MachFour/ambika/controller/hardware_design/pcb/max/Mobo-v09.brd

## EAGLE design controller/hardware_design/pcb/max/Mobo-v09.brd (2020-03-29)

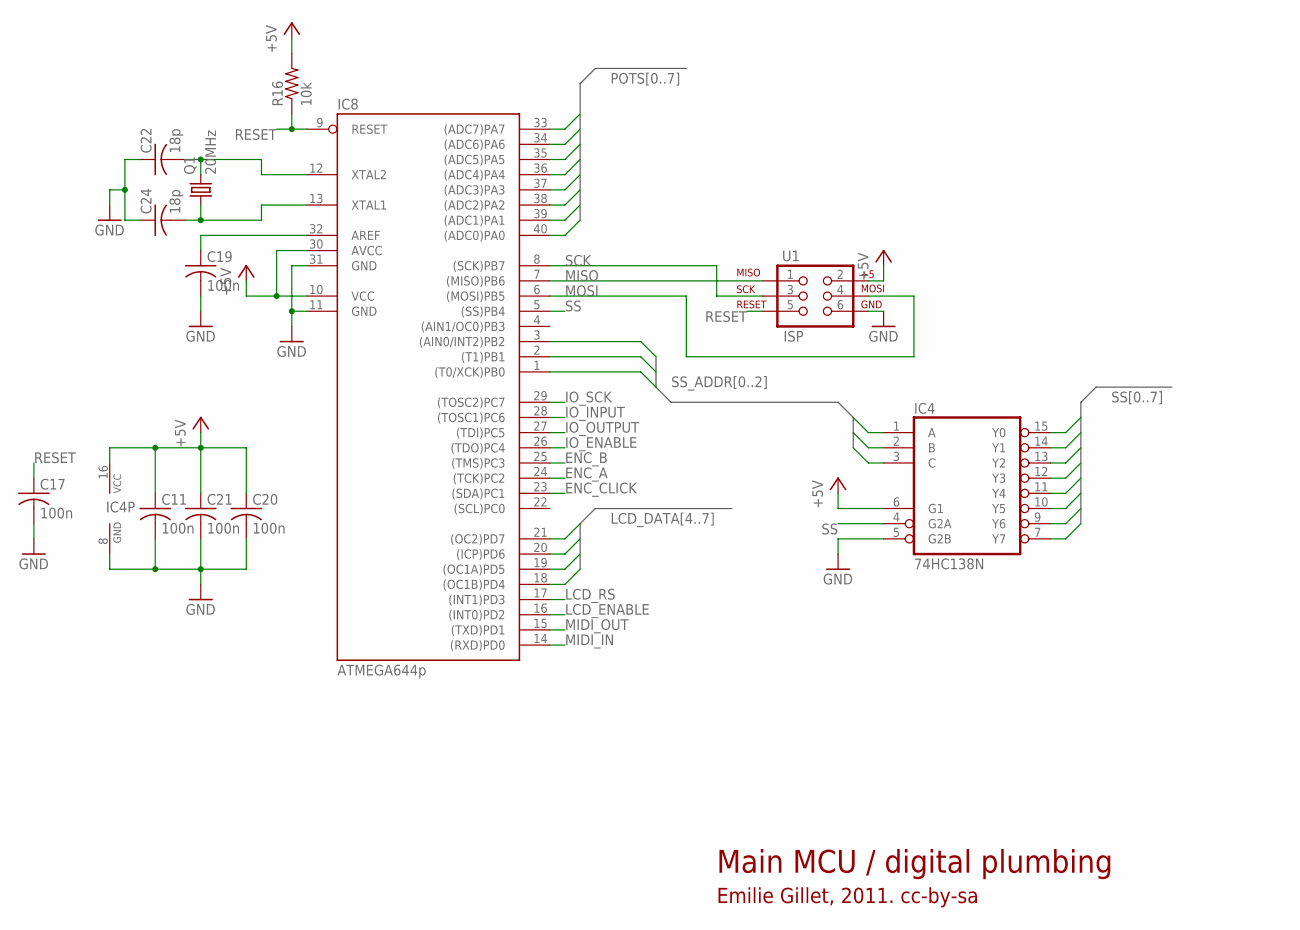
[picture p1: schematic Mobo-v09.sch, sheet 1]

Parts:
C11, C17, C19, C20, C21: 100n; C025-024X044
C22, C24: 18p; C025-024X044
IC4: 74HC138N; DIL16
IC8: ATMEGA644p; DIL40
Q1: 20MHz; HC49U-V
R16: 10k; 0204/7
U1: ISP; 2X3

Connections:
+5V: C11.1, C20.1, C21.1, IC4.6 (G1), IC4.16 (VCC), IC8.10 (VCC), IC8.30 (AVCC), R16.2, U1.2; also elsewhere on the board
ENC_A: IC8.24 ((TCK)PC2); also elsewhere on the board
ENC_B: IC8.25 ((TMS)PC3); also elsewhere on the board
ENC_CLICK: IC8.23 ((SDA)PC1); also elsewhere on the board
GND: C11.2, C17.2, C19.2, C20.2, C21.2, C22.1, C24.1, IC4.5 (G2B), IC4.8 (GND), IC8.11 (GND), IC8.31 (GND), U1.6; also elsewhere on the board
IO_ENABLE: IC8.26 ((TDO)PC4); also elsewhere on the board
IO_INPUT: IC8.28 ((TOSC1)PC6); also elsewhere on the board
IO_OUTPUT: IC8.27 ((TDI)PC5); also elsewhere on the board
IO_SCK: IC8.29 ((TOSC2)PC7); also elsewhere on the board
LCD_DATA4: IC8.18 ((OC1B)PD4); also elsewhere on the board
LCD_DATA5: IC8.19 ((OC1A)PD5); also elsewhere on the board
LCD_DATA6: IC8.20 ((ICP)PD6); also elsewhere on the board
LCD_DATA7: IC8.21 ((OC2)PD7); also elsewhere on the board
LCD_ENABLE: IC8.16 ((INT0)PD2); also elsewhere on the board
LCD_RS: IC8.17 ((INT1)PD3); also elsewhere on the board
MIDI_IN: IC8.14 ((RXD)PD0); also elsewhere on the board
MIDI_OUT: IC8.15 ((TXD)PD1); also elsewhere on the board
MISO: IC8.7 ((MISO)PB6), U1.1; also elsewhere on the board
MOSI: IC8.6 ((MOSI)PB5), U1.4; also elsewhere on the board
unnamed: C19.1, IC8.32 (AREF)
unnamed: C24.2, IC8.13 (XTAL1), Q1.1
unnamed: C22.2, IC8.12 (XTAL2), Q1.2
POTS0: IC8.40 ((ADC0)PA0); also elsewhere on the board
POTS1: IC8.39 ((ADC1)PA1); also elsewhere on the board
POTS2: IC8.38 ((ADC2)PA2); also elsewhere on the board
POTS3: IC8.37 ((ADC3)PA3); also elsewhere on the board
POTS4: IC8.36 ((ADC4)PA4); also elsewhere on the board
POTS5: IC8.35 ((ADC5)PA5); also elsewhere on the board
POTS6: IC8.34 ((ADC6)PA6); also elsewhere on the board
POTS7: IC8.33 ((ADC7)PA7); also elsewhere on the board
RESET: C17.1, IC8.9 (RESET), R16.1, U1.5
SCK: IC8.8 ((SCK)PB7), U1.3; also elsewhere on the board
SS: IC4.4 (G2A), IC8.5 ((SS)PB4)
SS0: IC4.15 (Y0); also elsewhere on the board
SS1: IC4.14 (Y1); also elsewhere on the board
SS2: IC4.13 (Y2); also elsewhere on the board
SS3: IC4.12 (Y3); also elsewhere on the board
SS4: IC4.11 (Y4); also elsewhere on the board
SS5: IC4.10 (Y5); also elsewhere on the board
SS6: IC4.9 (Y6); also elsewhere on the board
SS7: IC4.7 (Y7); also elsewhere on the board
SS_ADDR0: IC4.1 (A), IC8.1 ((T0/XCK)PB0)
SS_ADDR1: IC4.2 (B), IC8.2 ((T1)PB1)
SS_ADDR2: IC4.3 (C), IC8.3 ((AIN0/INT2)PB2)

Notes on the sheet:
Main MCU / digital plumbing
Emilie Gillet, 2011. cc-by-sa

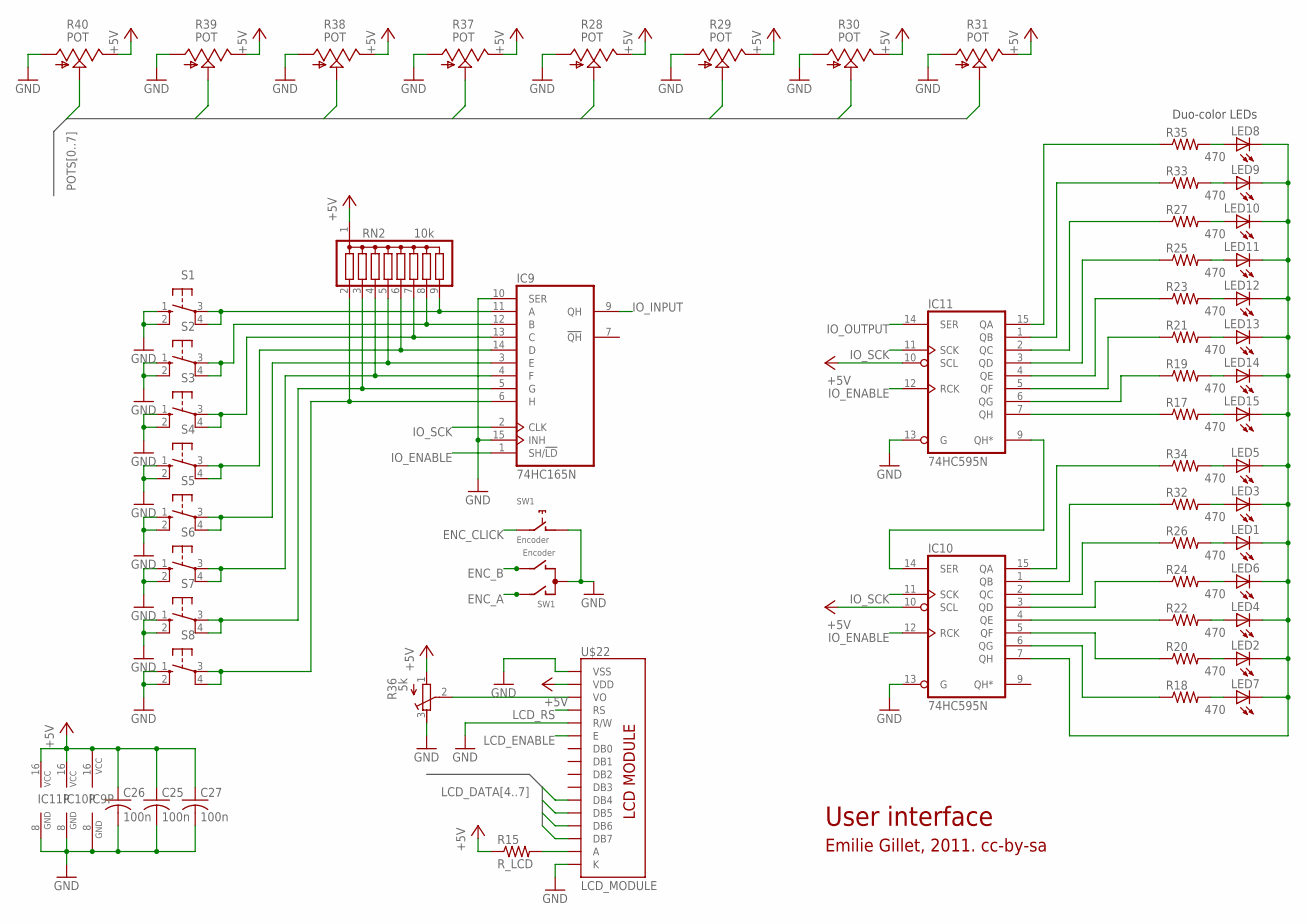
[picture p2: schematic Mobo-v09.sch, sheet 2]

Parts:
C25, C26, C27: 100n; C025-024X044
IC9: 74HC165N; DIL16
IC10, IC11: 74HC595N; DIL16
LED1, LED2, LED3, LED4, LED5, LED6, LED7, LED8, LED9, LED10, LED11, LED12, LED13, LED14, LED15: LED3MM
R15: R_LCD; 0204/7
R17, R18, R19, R20, R21, R22, R23, R24, R25, R26, R27, R32, R33, R34, R35: 470; 0204/7
R28, R29, R30, R31, R37, R38, R39, R40: POT; ALPS_POT_VERTICAL
R36: 5k; RTRIM3339P
RN2: 10k; SIL9
S1, S2, S3, S4, S5, S6, S7, S8: 40-XX; B3F-40XX
SW1: Encoder; ALPS_EC12E_SW
U$22: LCD_MODULE; LCD_MODULE_2X40

Connections:
+5V: C25.1, C26.1, C27.1, IC9.16 (VCC), IC10.10 (SCL), IC10.16 (VCC), IC11.10 (SCL), IC11.16 (VCC), R15.1, R28.P$1 (E), R29.P$1 (E), R30.P$1 (E), R31.P$1 (E), R36.1 (E), R37.P$1 (E), R38.P$1 (E), R39.P$1 (E), R40.P$1 (E), RN2.1, U$22.2 (VDD); also elsewhere on the board
ENC_A: SW1.A; also elsewhere on the board
ENC_B: SW1.B; also elsewhere on the board
ENC_CLICK: SW1.E (2); also elsewhere on the board
GND: C25.2, C26.2, C27.2, IC9.8 (GND), IC9.10 (SER), IC9.15 (INH), IC10.8 (GND), IC10.13 (G), IC11.8 (GND), IC11.13 (G), R28.P$3 (A), R29.P$3 (A), R30.P$3 (A), R31.P$3 (A), R36.3 (A), R37.P$3 (A), R38.P$3 (A), R39.P$3 (A), R40.P$3 (A), S1.1 (S), S1.2 (S1), S2.1 (S), S2.2 (S1), S3.1 (S), S3.2 (S1), S4.1 (S), S4.2 (S1), S5.1 (S), S5.2 (S1), S6.1 (S), S6.2 (S1), S7.1 (S), S7.2 (S1), S8.1 (S), S8.2 (S1), SW1.C, SW1.D (1), U$22.1 (VSS), U$22.5 (R/W), U$22.16 (K); also elsewhere on the board
IO_ENABLE: IC9.1 (SH/!LD), IC10.12 (RCK), IC11.12 (RCK); also elsewhere on the board
IO_INPUT: IC9.9 (QH); also elsewhere on the board
IO_OUTPUT: IC11.14 (SER); also elsewhere on the board
IO_SCK: IC9.2 (CLK), IC10.11 (SCK), IC11.11 (SCK); also elsewhere on the board
LCD_DATA4: U$22.11 (DB4); also elsewhere on the board
LCD_DATA5: U$22.12 (DB5); also elsewhere on the board
LCD_DATA6: U$22.13 (DB6); also elsewhere on the board
LCD_DATA7: U$22.14 (DB7); also elsewhere on the board
LCD_ENABLE: U$22.6 (E); also elsewhere on the board
LCD_RS: U$22.4 (RS); also elsewhere on the board
unnamed: IC11.2 (QC), R27.1
unnamed: IC9.3 (E), RN2.5, S5.3, S5.4 (P1)
unnamed: IC9.5 (G), RN2.3, S7.3, S7.4 (P1)
unnamed: IC9.4 (F), RN2.4, S6.3, S6.4 (P1)
unnamed: IC9.14 (D), RN2.6, S4.3, S4.4 (P1)
unnamed: R36.2 (S), U$22.3 (VO)
unnamed: IC9.11 (A), RN2.9, S1.3, S1.4 (P1)
unnamed: IC11.15 (QA), R35.1
unnamed: IC11.1 (QB), R33.1
unnamed: IC11.3 (QD), R25.1
unnamed: IC11.4 (QE), R23.1
unnamed: IC11.5 (QF), R21.1
unnamed: IC11.7 (QH), R17.1
unnamed: IC11.6 (QG), R19.1
unnamed: LED8.A, R35.2
unnamed: LED9.A, R33.2
unnamed: LED10.A, R27.2
unnamed: LED11.A, R25.2
unnamed: LED12.A, R23.2
unnamed: LED13.A, R21.2
unnamed: LED14.A, R19.2
unnamed: LED15.A, R17.2
unnamed: IC10.7 (QH), LED1.K (C), LED2.K (C), LED3.K (C), LED4.K (C), LED5.K (C), LED6.K (C), LED7.K (C), LED8.K (C), LED9.K (C), LED10.K (C), LED11.K (C), LED12.K (C), LED13.K (C), LED14.K (C), LED15.K (C)
unnamed: IC10.15 (QA), R34.1
unnamed: IC10.1 (QB), R32.1
unnamed: IC10.3 (QD), R24.1
unnamed: IC10.4 (QE), R22.1
unnamed: IC10.5 (QF), R20.1
unnamed: LED5.A, R34.2
unnamed: LED3.A, R32.2
unnamed: R15.2, U$22.15 (A)
unnamed: LED1.A, R26.2
unnamed: LED6.A, R24.2
unnamed: LED4.A, R22.2
unnamed: LED2.A, R20.2
unnamed: IC10.14 (SER), IC11.9 (QH*)
unnamed: IC9.12 (B), RN2.8, S2.3, S2.4 (P1)
unnamed: IC10.2 (QC), R26.1
unnamed: IC9.13 (C), RN2.7, S3.3, S3.4 (P1)
unnamed: IC9.6 (H), RN2.2, S8.3, S8.4 (P1)
unnamed: LED7.A, R18.2
unnamed: IC10.6 (QG), R18.1
POTS0: R40.P$2 (S); also elsewhere on the board
POTS1: R39.P$2 (S); also elsewhere on the board
POTS2: R38.P$2 (S); also elsewhere on the board
POTS3: R37.P$2 (S); also elsewhere on the board
POTS4: R28.P$2 (S); also elsewhere on the board
POTS5: R29.P$2 (S); also elsewhere on the board
POTS6: R30.P$2 (S); also elsewhere on the board
POTS7: R31.P$2 (S); also elsewhere on the board

Notes on the sheet:
User interface
Duo-color LEDs
Emilie Gillet, 2011. cc-by-sa

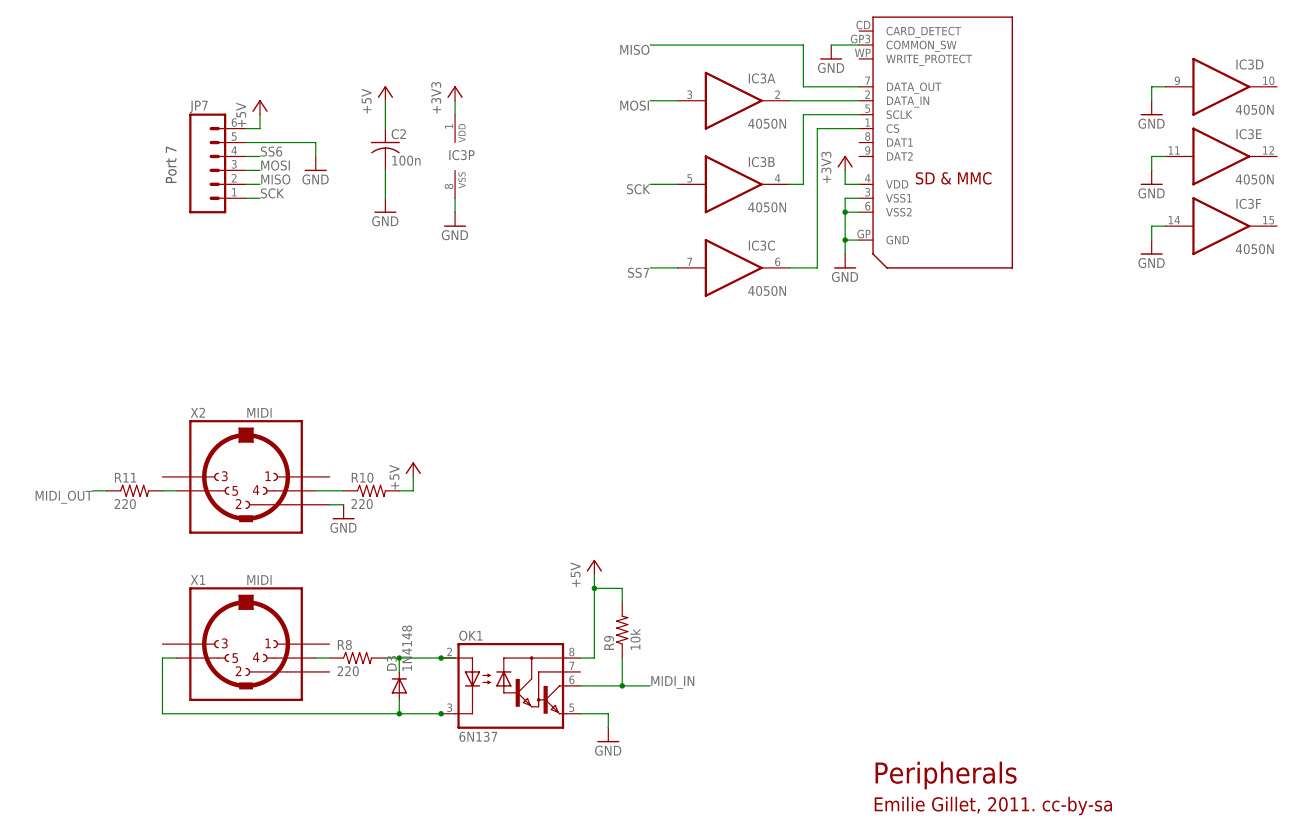
[picture p3: schematic Mobo-v09.sch, sheet 3]

Parts:
C2: 100n; C025-024X044
D3: 1N4148; D-5
IC3: 4050N; DIL16
JP7: M06SIP; 1X06
OK1: 6N137; DIL08
R8, R10, R11: 220; 0204/7
R9: 10k; 0204/7
U$26: SDMMC06132; 06132
X1, X2: MIDI; MAB5SH

Connections:
+3V3: IC3.1 (VDD), U$26.4 (VDD); also elsewhere on the board
+5V: C2.1, JP7.6, OK1.8 (VCC), R9.2, R10.2; also elsewhere on the board
GND: C2.2, IC3.8 (VSS), IC3.9 (I), IC3.11 (I), IC3.14 (I), JP7.5, OK1.5 (GND), U$26.3 (VSS1), U$26.6 (VSS2), U$26.GP (GND), U$26.GP3 (COMMON_SW), X2.2; also elsewhere on the board
MIDI_IN: OK1.6 (VO), R9.1; also elsewhere on the board
MIDI_OUT: R11.1; also elsewhere on the board
MISO: JP7.2, U$26.7 (DATA_OUT); also elsewhere on the board
MOSI: IC3.3 (I), JP7.3; also elsewhere on the board
MOSI_3V3: IC3.2 (O), U$26.2 (DATA_IN)
unnamed: R11.2, X2.5
unnamed: D3.C, OK1.2 (A), R8.2
unnamed: R10.1, X2.4
unnamed: R8.1, X1.4
unnamed: D3.A, OK1.3 (C), X1.5
SCK: IC3.5 (I), JP7.1; also elsewhere on the board
SCK_3V3: IC3.4 (O), U$26.5 (SCLK)
SS6: JP7.4; also elsewhere on the board
SS7: IC3.7 (I); also elsewhere on the board
SS7_3V3: IC3.6 (O), U$26.1 (CS)

Notes on the sheet:
Peripherals
Emilie Gillet, 2011. cc-by-sa
Port 7

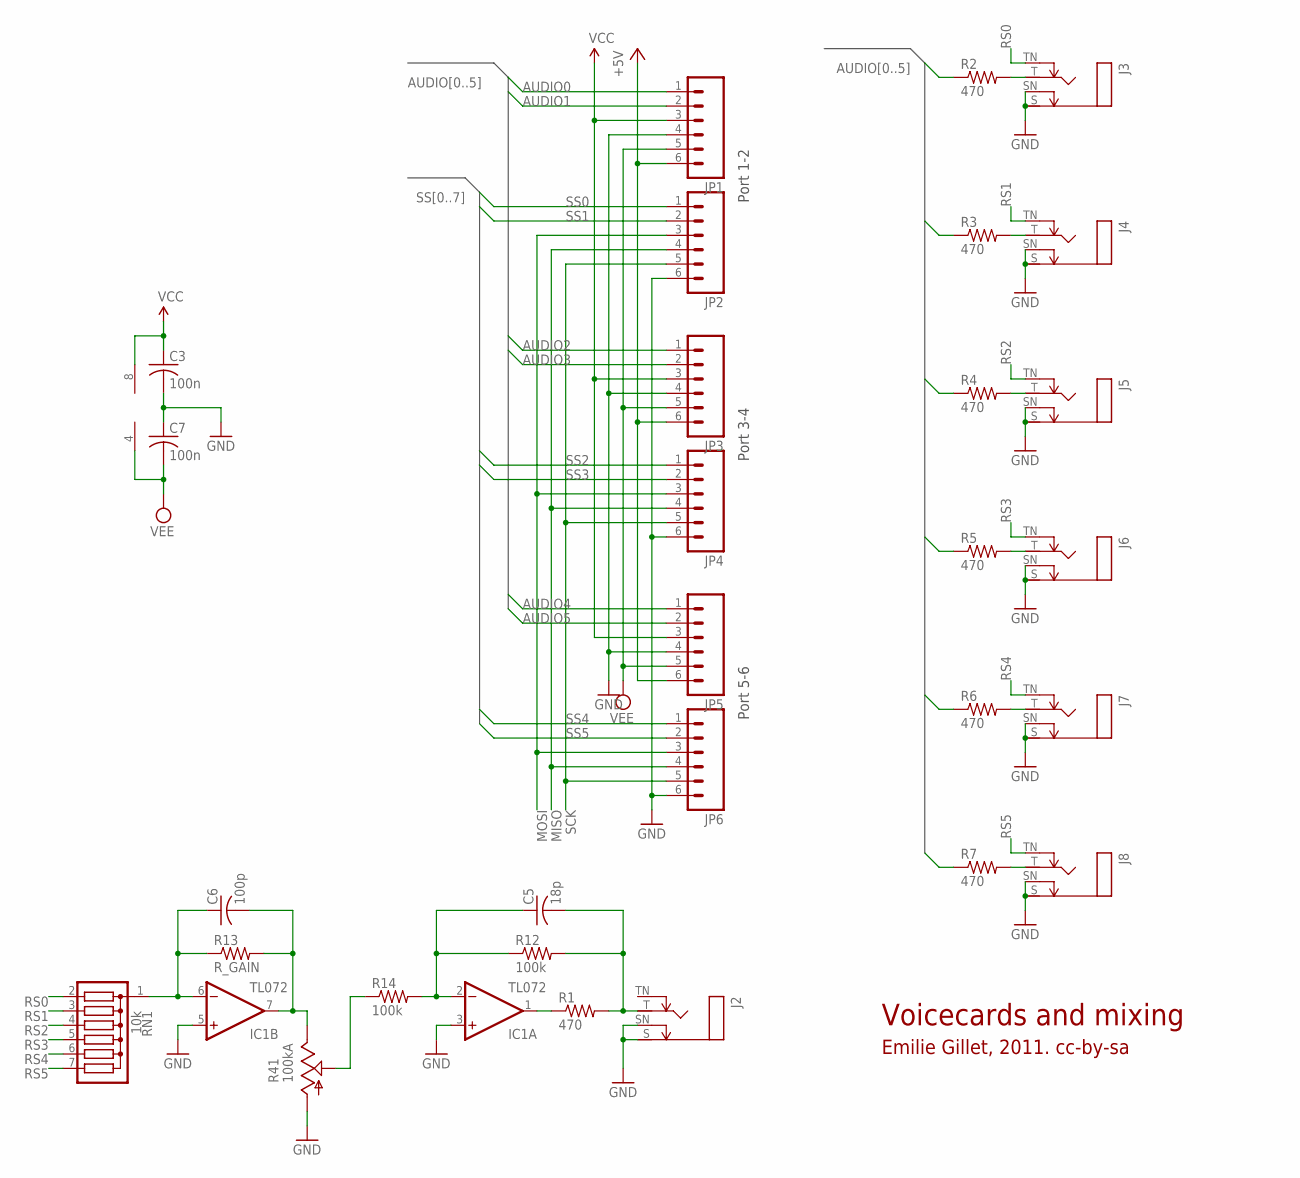
[picture p4: schematic Mobo-v09.sch, sheet 4]

Parts:
C3, C7: 100n; C025-024X044
C5: 18p; C025-024X044
C6: 100p; C025-024X044
IC1: TL072; DIL08
J2, J3, J4, J5, J6, J7, J8: MONOSWSLIM; NRJ4HF
JP1, JP2, JP3, JP4, JP5, JP6: M06SIP; 1X06
R1, R2, R3, R4, R5, R6, R7: 470; 0204/7
R12, R14: 100k; 0204/7
R13: R_GAIN; 0204/7
R41: 100kA; ALPS_POT_VERTICAL
RN1: 10k; SIL7

Connections:
+5V: JP1.6, JP3.6, JP5.6; also elsewhere on the board
AUDIO0: JP1.1, R2.1
AUDIO1: JP1.2, R3.1
AUDIO2: JP3.1, R4.1
AUDIO3: JP3.2, R5.1
AUDIO4: JP5.1, R6.1
AUDIO5: JP5.2, R7.1
GND: C3.2, C7.1, IC1.3 (+IN), IC1.5 (+IN), J2.S, J2.SN, J3.S, J3.SN, J4.S, J4.SN, J5.S, J5.SN, J6.S, J6.SN, J7.S, J7.SN, J8.S, J8.SN, JP1.4, JP2.6, JP3.4, JP4.6, JP5.4, JP6.6, R41.P$3 (A); also elsewhere on the board
MISO: JP2.4, JP4.4, JP6.4; also elsewhere on the board
MOSI: JP2.3, JP4.3, JP6.3; also elsewhere on the board
unnamed: C6.2, IC1.7 (OUT), R13.2, R41.P$1 (E)
unnamed: C6.1, IC1.6 (-IN), R13.1, RN1.1
unnamed: R14.1, R41.P$2 (S)
unnamed: C5.1, IC1.2 (-IN), R12.1, R14.2
unnamed: C5.2, J2.T, R1.2, R12.2
unnamed: J3.T, R2.2
unnamed: J4.T, R3.2
unnamed: J5.T, R4.2
unnamed: J6.T, R5.2
unnamed: J7.T, R6.2
unnamed: J8.T, R7.2
unnamed: IC1.1 (OUT), R1.1
RS0: J3.TN, RN1.2
RS1: J4.TN, RN1.3
RS2: J5.TN, RN1.4
RS3: J6.TN, RN1.5
RS4: J7.TN, RN1.6
RS5: J8.TN, RN1.7
SCK: JP2.5, JP4.5, JP6.5; also elsewhere on the board
SS0: JP2.1; also elsewhere on the board
SS1: JP2.2; also elsewhere on the board
SS2: JP4.1; also elsewhere on the board
SS3: JP4.2; also elsewhere on the board
SS4: JP6.1; also elsewhere on the board
SS5: JP6.2; also elsewhere on the board
VCC: C3.1, IC1.8 (V+), JP1.3, JP3.3, JP5.3; also elsewhere on the board
VEE: C7.2, IC1.4 (V-), JP1.5, JP3.5, JP5.5; also elsewhere on the board

Notes on the sheet:
Voicecards and mixing
Emilie Gillet, 2011. cc-by-sa
Port 1-2
Port 3-4
Port 5-6

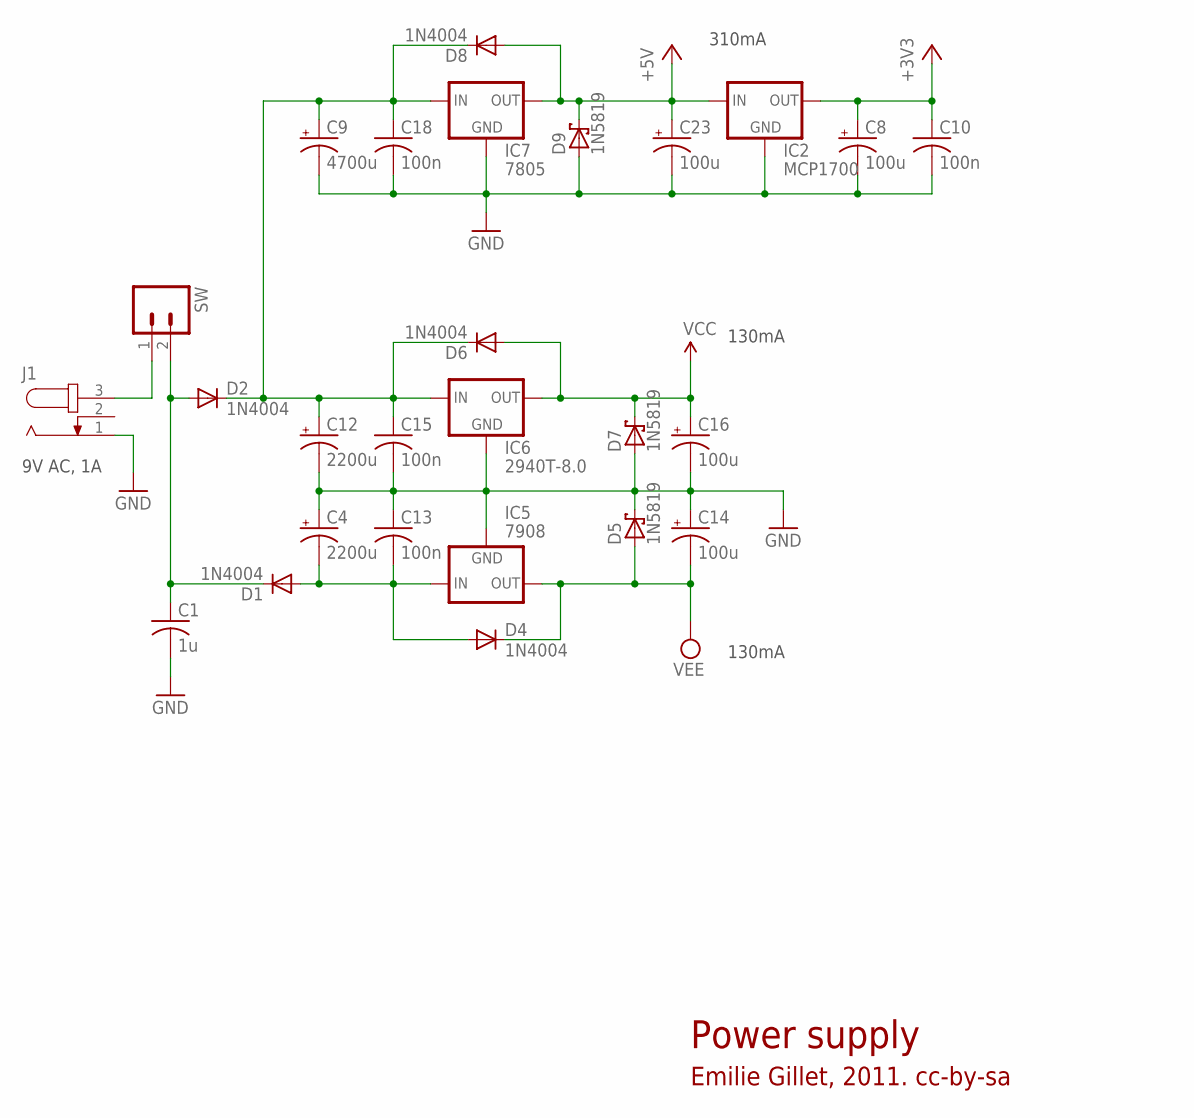
[picture p5: schematic Mobo-v09.sch, sheet 5]

Parts:
C1: 1u; C075-052X106
C4, C12: 2200u; E5-13
C8, C14, C16, C23: 100u; E2,5-7
C9: 4700u; E7,5-16
C10: 100n; C025-024X044
C13, C15, C18: 100n; C025-025X050
D1, D2, D4, D6, D8: 1N4004; DO41-10
D5, D7, D9: 1N5819; DO41-7.6
IC2: MCP1700; TO92-INLINE
IC5: 7908; 79XXL
IC6: 2940T-8.0; 78XXL
IC7: 7805; 78XXL
J1: JACK-PLUG2; SPC4078_BIG_HOLES
SW: M02PTH; 1X02

Connections:
+3V3: C8.+, C10.1, IC2.3 (OUT); also elsewhere on the board
+5V: C23.+, D8.A, D9.C, IC2.2 (IN), IC7.OUT; also elsewhere on the board
GND: C1.2, C4.+, C8.-, C9.-, C10.2, C12.-, C13.1, C14.+, C15.2, C16.-, C18.2, C23.-, D5.C, D7.A, D9.A, IC2.1 (GND), IC5.GND, IC6.GND, IC7.GND, J1.1; also elsewhere on the board
unnamed: J1.3, SW.1
unnamed: C4.-, C13.2, D1.A, D4.A, IC5.IN
unnamed: C9.+, C12.+, C15.1, C18.1, D2.C, D6.C, D8.C, IC6.IN, IC7.IN
unnamed: C1.1, D1.C, D2.A, SW.2
VCC: C16.+, D6.A, D7.C, IC6.OUT; also elsewhere on the board
VEE: C14.-, D4.C, D5.A, IC5.OUT; also elsewhere on the board

Notes on the sheet:
9V AC, 1A
Power supply
Emilie Gillet, 2011. cc-by-sa
130mA
310mA

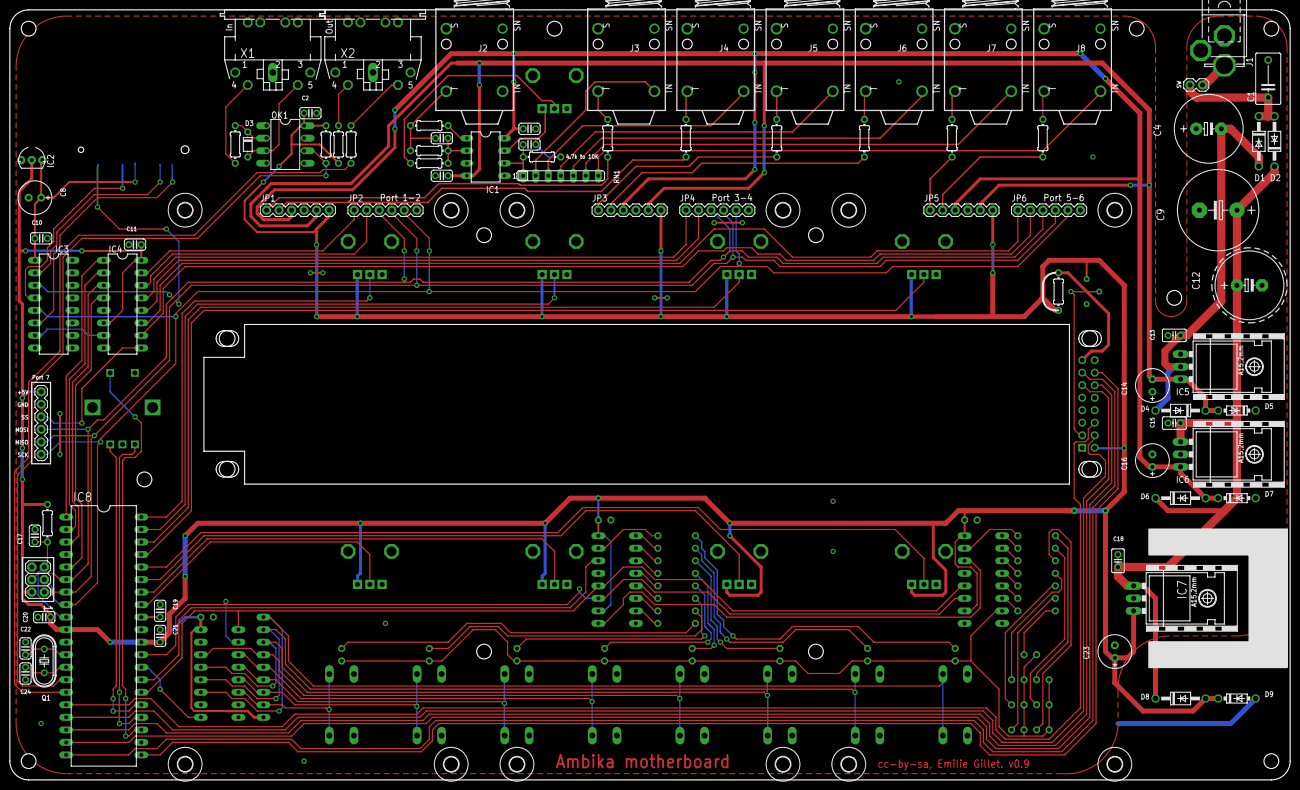
[picture p6: board Mobo-v09.brd from above]

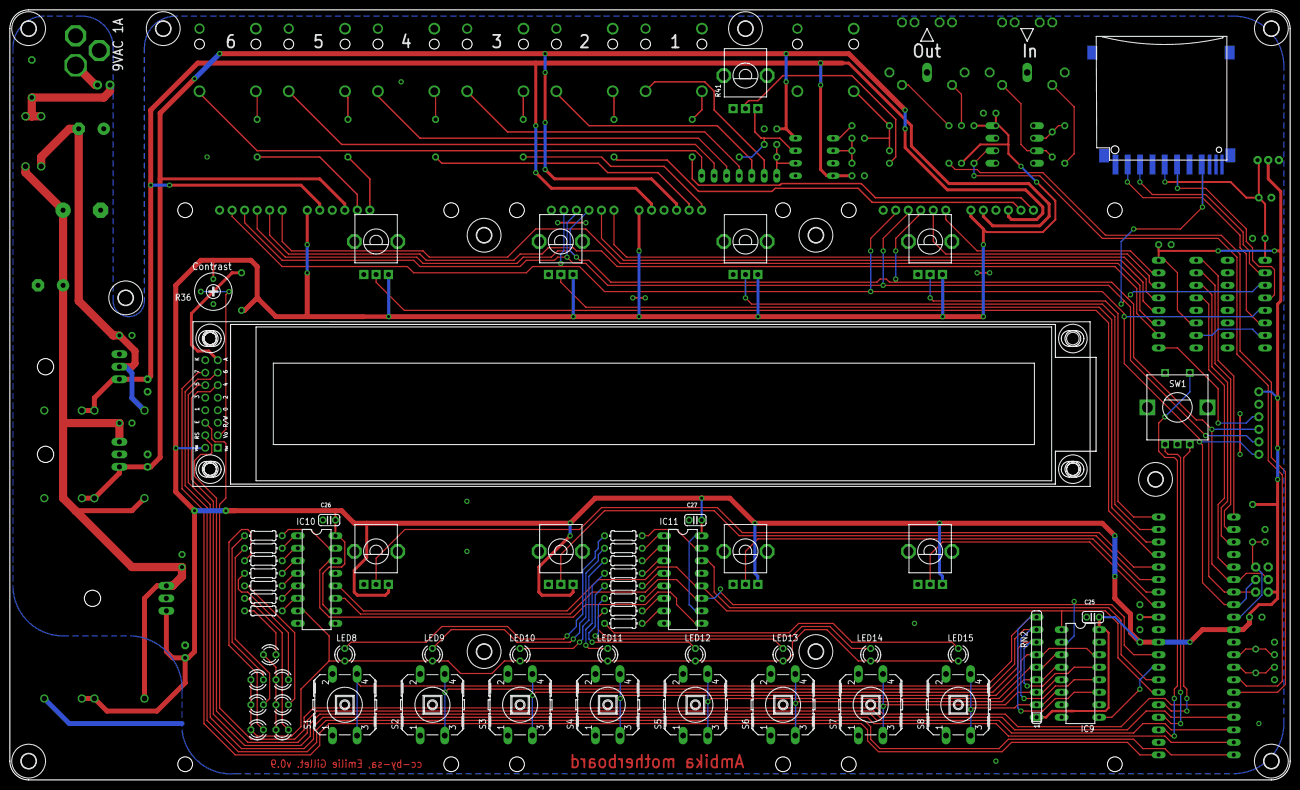
[picture p7: board Mobo-v09.brd from below]

Board: 2 copper layers, 259.7 x 156.2 mm, 165 parts (70 on the bottom side), 125 nets.

Other parts of the board:
U$1: V2_LOGO
U$2, U$3, U$4, U$5, U$6, U$7, U$11, U$12, U$13, U$14, U$15, U$16, U$17, U$18, U$19, U$20, U$21, U$23, U$24, U$25, U$27, U$28, U$29, U$30: 3,0
U$8, U$9, U$10: D02A-L
