MachFour/ambika/controller/resources-bak/resources.h

// Copyright 2009 Emilie Gillet.
//
// Author: Emilie Gillet (emilie.o.gillet@gmail.com)
//
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
// -----------------------------------------------------------------------------
//
// Resources definitions.
//
// Automatically generated with:
// make resources


#ifndef CONTROLLER_RESOURCES_H_
#define CONTROLLER_RESOURCES_H_


#include "avrlib/base.h"

#include <avr/pgmspace.h>


#include "avrlib/resources_manager.h"

namespace ambika {

typedef uint16_t ResourceId;

extern const char* const string_table[];

extern const uint16_t* const lookup_table_table[];

extern const uint8_t* const character_table[];

extern const uint8_t* const waveform_table[];

extern const uint16_t lut_res_lfo_increments[] PROGMEM;
extern const uint16_t lut_res_scale_just[] PROGMEM;
extern const uint16_t lut_res_scale_pythagorean[] PROGMEM;
extern const uint16_t lut_res_scale_1_4_eb[] PROGMEM;
extern const uint16_t lut_res_scale_1_4_e[] PROGMEM;
extern const uint16_t lut_res_scale_1_4_ea[] PROGMEM;
extern const uint16_t lut_res_scale_bhairav[] PROGMEM;
extern const uint16_t lut_res_scale_gunakri[] PROGMEM;
extern const uint16_t lut_res_scale_marwa[] PROGMEM;
extern const uint16_t lut_res_scale_shree[] PROGMEM;
extern const uint16_t lut_res_scale_purvi[] PROGMEM;
extern const uint16_t lut_res_scale_bilawal[] PROGMEM;
extern const uint16_t lut_res_scale_yaman[] PROGMEM;
extern const uint16_t lut_res_scale_kafi[] PROGMEM;
extern const uint16_t lut_res_scale_bhimpalasree[] PROGMEM;
extern const uint16_t lut_res_scale_darbari[] PROGMEM;
extern const uint16_t lut_res_scale_rageshree[] PROGMEM;
extern const uint16_t lut_res_scale_khamaj[] PROGMEM;
extern const uint16_t lut_res_scale_mimal[] PROGMEM;
extern const uint16_t lut_res_scale_parameshwari[] PROGMEM;
extern const uint16_t lut_res_scale_rangeshwari[] PROGMEM;
extern const uint16_t lut_res_scale_gangeshwari[] PROGMEM;
extern const uint16_t lut_res_scale_kameshwari[] PROGMEM;
extern const uint16_t lut_res_scale_pa__kafi[] PROGMEM;
extern const uint16_t lut_res_scale_natbhairav[] PROGMEM;
extern const uint16_t lut_res_scale_m_kauns[] PROGMEM;
extern const uint16_t lut_res_scale_bairagi[] PROGMEM;
extern const uint16_t lut_res_scale_b_todi[] PROGMEM;
extern const uint16_t lut_res_scale_chandradeep[] PROGMEM;
extern const uint16_t lut_res_scale_kaushik_todi[] PROGMEM;
extern const uint16_t lut_res_scale_jogeshwari[] PROGMEM;
extern const uint16_t lut_res_arpeggiator_patterns[] PROGMEM;
extern const uint16_t lut_res_groove_swing[] PROGMEM;
extern const uint16_t lut_res_groove_shuffle[] PROGMEM;
extern const uint16_t lut_res_groove_push[] PROGMEM;
extern const uint16_t lut_res_groove_lag[] PROGMEM;
extern const uint16_t lut_res_groove_human[] PROGMEM;
extern const uint16_t lut_res_groove_monkey[] PROGMEM;
extern const uint8_t chr_res_special_characters[] PROGMEM;
extern const uint8_t wav_res_lfo_waveforms[] PROGMEM;
#define STR_RES_WAVEFORM 0  // waveform
#define STR_RES_PARAMETER 1  // parameter
#define STR_RES_RANGE 2  // range
#define STR_RES_TUNE 3  // tune
#define STR_RES_OSC_MIX 4  // osc mix
#define STR_RES_SUB_OSC_ 5  // sub osc.
#define STR_RES_CROSSMOD_ 6  // crossmod.
#define STR_RES_OPERATOR 7  // operator
#define STR_RES_AMOUNT 8  // amount
#define STR_RES_RESONANCE 9  // resonance
#define STR_RES_MODE 10  // mode
#define STR_RES_ENV2TVCF 11  // env2~vcf
#define STR_RES_LFO2TVCF 12  // lfo2~vcf
#define STR_RES_VELOTVCF 13  // velo~vcf
#define STR_RES_KEYBTVCF 14  // keyb~vcf
#define STR_RES_ATTACK 15  // attack
#define STR_RES_DECAY 16  // decay
#define STR_RES_SUSTAIN 17  // sustain
#define STR_RES_RELEASE 18  // release
#define STR_RES_TRIGGER 19  // trigger
#define STR_RES_RATE 20  // rate
#define STR_RES_LFO_EG 21  // lfo/eg
#define STR_RES_VOICE_LFO 22  // voice lfo
#define STR_RES_SOURCE 23  // source
#define STR_RES_DESTINATION 24  // destination
#define STR_RES_IN1 25  // in1
#define STR_RES_IN2 26  // in2
#define STR_RES_MODULATION 27  // modulation
#define STR_RES_MODUL_ 28  // modul.
#define STR_RES__MODULATION 29  // modulation
#define STR_RES_MODIFIER 30  // modifier
#define STR_RES_MODIF_ 31  // modif.
#define STR_RES_VOLUME 32  // volume
#define STR_RES_OCTAVE 33  // octave
#define STR_RES_SPREAD 34  // spread
#define STR_RES_LEGATO 35  // legato
#define STR_RES_PORTAMENTO 36  // portamento
#define STR_RES_ARP_SEQ 37  // arp/seq
#define STR_RES_RAGA 38  // raga
#define STR_RES_DIRECTION 39  // direction
#define STR_RES_PATTERN 40  // pattern
#define STR_RES_CHANNEL 41  // channel
#define STR_RES_PART 42  // part
#define STR_RES_BPM 43  // bpm
#define STR_RES_LTCH 44  // ltch
#define STR_RES_LATCH 45  // latch
#define STR_RES_LOW 46  // low
#define STR_RES_HIGH 47  // high
#define STR_RES_GRID 48  // grid
#define STR_RES_SEQ1_LEN 49  // seq1 len
#define STR_RES_SEQ2_LEN 50  // seq2 len
#define STR_RES_PATT_LEN 51  // patt len
#define STR_RES_LEN1 52  // len1
#define STR_RES_LEN2 53  // len2
#define STR_RES_LENP 54  // lenp
#define STR_RES_GROOVE 55  // groove
#define STR_RES_MIDI 56  // midi
#define STR_RES_SNAP 57  // snap
#define STR_RES_HELP 58  // help
#define STR_RES_AUTO_BACKUP 59  // auto backup
#define STR_RES_LEDS 60  // leds
#define STR_RES_CARD_LEDS 61  // card leds
#define STR_RES_SWAP_COLORS 62  // swap colors
#define STR_RES_INPT_FILTER 63  // inpt filter
#define STR_RES_OUTP_MODE 64  // outp mode
#define STR_RES_EXT 65  // ext
#define STR_RES_OMNI 66  // omni
#define STR_RES_AMNT 67  // amnt
#define STR_RES_SRCE 68  // srce
#define STR_RES_OCT 69  // oct
#define STR_RES_SPRD 70  // sprd
#define STR_RES_A_SQ 71  // a/sq
#define STR_RES_OCTV 72  // octv
#define STR_RES_OFF 73  // off
#define STR_RES_ON 74  // on
#define STR_RES_NONE 75  // none
#define STR_RES_SAW 76  // saw
#define STR_RES_SQUARE 77  // square
#define STR_RES_TRIANGLE 78  // triangle
#define STR_RES_SINE 79  // sine
#define STR_RES_ZSAW 80  // zsaw
#define STR_RES_LPZSAW 81  // lpzsaw
#define STR_RES_PKZSAW 82  // pkzsaw
#define STR_RES_BPZSAW 83  // bpzsaw
#define STR_RES_HPZSAW 84  // hpzsaw
#define STR_RES_LPZPULSE 85  // lpzpulse
#define STR_RES_PKZPULSE 86  // pkzpulse
#define STR_RES_BPZPULSE 87  // bpzpulse
#define STR_RES_HPZPULSE 88  // hpzpulse
#define STR_RES_ZTRIANGLE 89  // ztriangle
#define STR_RES_PAD 90  // pad
#define STR_RES_FM 91  // fm
#define STR_RES_8BITS 90  // 10bits
#define STR_RES_PWM 93  // pwm
#define STR_RES_NOISE 94  // noise
#define STR_RES_VOWEL 95  // vowel
#define STR_RES_MALE 96  // male
#define STR_RES_FEMALE 97  // female
#define STR_RES_CHOIR 98  // choir
#define STR_RES_TAMPURA 99  // tampura
#define STR_RES_BOWED 100  // bowed
#define STR_RES_CELLO 101  // cello
#define STR_RES_VIBES 102  // vibes
#define STR_RES_SLAP 103  // slap
#define STR_RES_EPIANO 104  // epiano
#define STR_RES_ORGAN 105  // organ
#define STR_RES_WAVES 106  // waves
#define STR_RES_DIGITAL 107  // digital
#define STR_RES_DRONE_1 106  // drone 1
#define STR_RES_DRONE_2 107  // drone 2
#define STR_RES_METALLIC 110  // metallic
#define STR_RES_BELL 111  // bell
#define STR_RES_WAVQUENCE 112  // wavquence
#define STR_RES_TRI 113  // tri
#define STR_RES_SQR 114  // sqr
#define STR_RES_S_H 115  // s&h
#define STR_RES_RAMP 116  // ramp
#define STR_RES__SINE 117  // sine
#define STR_RES_HRM2 118  // hrm2
#define STR_RES_HRM3 119  // hrm3
#define STR_RES_HRM5 120  // hrm5
#define STR_RES_GRG1 121  // grg1
#define STR_RES_GRG2 122  // grg2
#define STR_RES_BAT1 123  // bat1
#define STR_RES_BAT2 124  // bat2
#define STR_RES_SPK1 125  // spk1
#define STR_RES_SPK2 126  // spk2
#define STR_RES_LSAW 127  // lsaw
#define STR_RES_LSQR 128  // lsqr
#define STR_RES_RSAW 129  // rsaw
#define STR_RES_RSQR 130  // rsqr
#define STR_RES_STP1 131  // stp1
#define STR_RES_STP2 132  // stp2
#define STR_RES___OFF 133  // off
#define STR_RES_SYNC 134  // sync
#define STR_RES_RINGMOD 135  // ringmod
#define STR_RES_XOR 136  // xor
#define STR_RES_FOLD 137  // fold
#define STR_RES_BITS 138  // bits
#define STR_RES_SQU1 139  // squ1
#define STR_RES_TRI1 140  // tri1
#define STR_RES_PUL1 141  // pul1
#define STR_RES_SQU2 142  // squ2
#define STR_RES_TRI2 143  // tri2
#define STR_RES_PUL2 144  // pul2
#define STR_RES_CLICK 145  // click
#define STR_RES_GLITCH 146  // glitch
#define STR_RES_BLOW 147  // blow
#define STR_RES_METAL 148  // metal
#define STR_RES_POP 149  // pop
#define STR_RES_ENV1 150  // env1
#define STR_RES_ENV2 151  // env2
#define STR_RES_ENV3 152  // env3
#define STR_RES_LFO1 153  // lfo1
#define STR_RES_LFO2 154  // lfo2
#define STR_RES_LFO3 155  // lfo3
#define STR_RES_LFO4 156  // lfo4
#define STR_RES_MOD1 157  // mod1
#define STR_RES_MOD2 158  // mod2
#define STR_RES_MOD3 159  // mod3
#define STR_RES_MOD4 160  // mod4
#define STR_RES_SEQ1 161  // seq1
#define STR_RES_SEQ2 162  // seq2
#define STR_RES_ARP 163  // arp
#define STR_RES_VELO 164  // velo
#define STR_RES_AFTR 165  // aftr
#define STR_RES_BEND 166  // bend
#define STR_RES_MWHL 167  // mwhl
#define STR_RES_WHL2 168  // whl2
#define STR_RES_PDAL 169  // pdal
#define STR_RES_NOTE 170  // note
#define STR_RES_GATE 171  // gate
#define STR_RES_NOIS 172  // nois
#define STR_RES_RAND 173  // rand
#define STR_RES_E256 174  // =256
#define STR_RES_E128 175  // =128
#define STR_RES_E64 176  // =64
#define STR_RES_E32 177  // =32
#define STR_RES_E16 178  // =16
#define STR_RES_E8 179  // =8
#define STR_RES_E4 180  // =4
#define STR_RES_PRM1 181  // prm1
#define STR_RES_PRM2 182  // prm2
#define STR_RES_OSC1 183  // osc1
#define STR_RES_OSC2 184  // osc2
#define STR_RES_31S2 185  // 1+2
#define STR_RES_VIBR 186  // vibr
#define STR_RES_MIX 187  // mix
#define STR_RES_XMOD 188  // xmod
#define STR_RES__NOIS 189  // nois
#define STR_RES_SUB 190  // sub
#define STR_RES_FUZZ 191  // fuzz
#define STR_RES_CRSH 192  // crsh
#define STR_RES_FREQ 193  // freq
#define STR_RES_RESO 194  // reso
#define STR_RES_ATTK 195  // attk
#define STR_RES_DECA 196  // deca
#define STR_RES_RELE 197  // rele
#define STR_RES__LFO4 198  // lfo4
#define STR_RES_VCA 199  // vca
#define STR_RES_ENV_1 198  // env 3
#define STR_RES_ENV_2 199  // env 4
#define STR_RES_ENV_3 200  // env 5
#define STR_RES_LFO_1 201  // lfo 3
#define STR_RES_LFO_2 202  // lfo 4
#define STR_RES_LFO_3 203  // lfo 5
#define STR_RES_LFO_4 204  // lfo 6
#define STR_RES_MOD__1 205  // mod. 3
#define STR_RES_MOD__2 206  // mod. 4
#define STR_RES_MOD__3 207  // mod. 5
#define STR_RES_MOD__4 208  // mod. 6
#define STR_RES_SEQ__1 209  // seq. 3
#define STR_RES_SEQ__2 210  // seq. 4
#define STR_RES__ARP 213  // arp
#define STR_RES__VELO 214  // velo
#define STR_RES_AFTTCH 215  // afttch
#define STR_RES_BENDER 216  // bender
#define STR_RES_MWHEEL 217  // mwheel
#define STR_RES_WHEEL2 218  // wheel2
#define STR_RES_PEDAL 219  // pedal
#define STR_RES__NOTE 220  // note
#define STR_RES__GATE 221  // gate
#define STR_RES__NOISE 222  // noise
#define STR_RES_RANDOM 223  // random
#define STR_RES_E_256 222  // = 258
#define STR_RES_E_32 223  // = 34
#define STR_RES_E_16 224  // = 18
#define STR_RES_E_8 225  // = 10
#define STR_RES_E_4 226  // = 6
#define STR_RES_PARAM_1 227  // param 3
#define STR_RES_PARAM_2 228  // param 4
#define STR_RES_OSC_1 229  // osc 3
#define STR_RES_OSC_2 230  // osc 4
#define STR_RES_OSC_1S2 231  // osc 3+2
#define STR_RES_VIBRATO 234  // vibrato
#define STR_RES__MIX 235  // mix
#define STR_RES__XMOD 236  // xmod
#define STR_RES___NOISE 237  // noise
#define STR_RES_SUBOSC 238  // subosc
#define STR_RES__FUZZ 239  // fuzz
#define STR_RES_CRUSH 240  // crush
#define STR_RES_FREQUENCY 241  // frequency
#define STR_RES__RESO 242  // reso
#define STR_RES__ATTACK 243  // attack
#define STR_RES__DECAY 244  // decay
#define STR_RES__RELEASE 245  // release
#define STR_RES__LFO_4 244  // lfo 6
#define STR_RES__VCA 247  // vca
#define STR_RES_LP 248  // lp
#define STR_RES_BP 249  // bp
#define STR_RES_HP 250  // hp
#define STR_RES_FREE 251  // free
#define STR_RES_ENVTLFO 252  // env~lfo
#define STR_RES_LFOTENV 253  // lfo~env
#define STR_RES_STEP_SEQ 254  // step seq
#define STR_RES_ARPEGGIO 255  // arpeggio
#define STR_RES__PATTERN 256  // pattern
#define STR_RES__OFF 257  // off
#define STR_RES_ADD 258  // add
#define STR_RES_PROD 259  // prod
#define STR_RES_ATTN 260  // attn
#define STR_RES_MAX 261  // max
#define STR_RES_MIN 262  // min
#define STR_RES__XOR 263  // xor
#define STR_RES_GE 264  // >=
#define STR_RES_LE 265  // <=
#define STR_RES_QTZ 266  // qtz
#define STR_RES_LAG 267  // lag
#define STR_RES_MONO 268  // mono
#define STR_RES_POLY 269  // poly
#define STR_RES_2X_UNISON 268  // 4x unison
#define STR_RES_CYCLIC 271  // cyclic
#define STR_RES_CHAIN 272  // chain
#define STR_RES_UP 273  // up
#define STR_RES_DOWN 274  // down
#define STR_RES_UP_DOWN 275  // up&down
#define STR_RES_PLAYED 276  // played
#define STR_RES__RANDOM 277  // random
#define STR_RES_CHORD 278  // chord
#define STR_RES_1_1 277  // 3/1
#define STR_RES_3_4 278  // 5/4
#define STR_RES_2_3 279  // 4/3
#define STR_RES_1_2 280  // 3/2
#define STR_RES_3_8 281  // 5/8
#define STR_RES_1_3 282  // 3/3
#define STR_RES_1_4 283  // 3/4
#define STR_RES_1_6 284  // 3/6
#define STR_RES_1_8 285  // 3/8
#define STR_RES_1_12 286  // 3/12
#define STR_RES_1_16 287  // 3/16
#define STR_RES_1_24 288  // 3/24
#define STR_RES_1_32 289  // 3/32
#define STR_RES_1_48 290  // 3/48
#define STR_RES_1_96 291  // 3/96
#define STR_RES_THRU 294  // thru
#define STR_RES_SEQUENCER 295  // sequencer
#define STR_RES_CONTROLLR 296  // controllr
#define STR_RES__CHAIN 297  // chain
#define STR_RES_FULL 298  // full
#define STR_RES_____ 299  // ....
#define STR_RES____S 300  // ...s
#define STR_RES___P_ 301  // ..p.
#define STR_RES___PS 302  // ..ps
#define STR_RES__N__ 303  // .n..
#define STR_RES__N_S 304  // .n.s
#define STR_RES__NP_ 305  // .np.
#define STR_RES__NPS 306  // .nps
#define STR_RES_C___ 307  // c...
#define STR_RES_C__S 308  // c..s
#define STR_RES_C_P_ 309  // c.p.
#define STR_RES_C_PS 310  // c.ps
#define STR_RES_CN__ 311  // cn..
#define STR_RES_CN_S 312  // cn.s
#define STR_RES_CNP_ 313  // cnp.
#define STR_RES_CNPS 314  // cnps
#define STR_RES_SWING 315  // swing
#define STR_RES_SHUFFLE 316  // shuffle
#define STR_RES_PUSH 317  // push
#define STR_RES__LAG 318  // lag
#define STR_RES_HUMAN 319  // human
#define STR_RES_MONKEY 320  // monkey
#define STR_RES_OSCILLATOR_1 319  // oscillator 1
#define STR_RES_OSCILLATOR_2 320  // oscillator 2
#define STR_RES_MIXER 323  // mixer
#define STR_RES_LFO 324  // lfo
#define STR_RES_FILTER_1 323  // filter 1
#define STR_RES_FILTER_2 324  // filter 2
#define STR_RES_ENVELOPE 327  // envelope
#define STR_RES_ARPEGGIATOR 328  // arpeggiator
#define STR_RES_MULTI 329  // multi
#define STR_RES_CLOCK 330  // clock
#define STR_RES_PERFORMANCE 331  // performance
#define STR_RES_SYSTEM 332  // system
#define STR_RES_PT_X_PATCH 333  // pt X patch
#define STR_RES_PT_X_SEQUENCE 334  // pt X sequence
#define STR_RES_PT_X_PROGRAM 335  // pt X program
#define STR_RES_RANDOMIZE 336  // randomize
#define STR_RES_INIT 337  // init
#define STR_RES_PATCH 338  // PATCH
#define STR_RES_SEQUENCE 339  // SEQUENCE
#define STR_RES_PROGRAM 340  // PROGRAM
#define STR_RES__MULTI 341  // MULTI
#define STR_RES____ 342  // ___
#define STR_RES_EQUAL 343  // equal
#define STR_RES_JUST 344  // just
#define STR_RES_PYTHAGOREAN 345  // pythagorean
#define STR_RES_1_4_EB 344  // 3/4 eb
#define STR_RES_1_4_E 345  // 3/4 e
#define STR_RES_1_4_EA 346  // 3/4 ea
#define STR_RES_BHAIRAV 349  // bhairav
#define STR_RES_GUNAKRI 350  // gunakri
#define STR_RES_MARWA 351  // marwa
#define STR_RES_SHREE 352  // shree
#define STR_RES_PURVI 353  // purvi
#define STR_RES_BILAWAL 354  // bilawal
#define STR_RES_YAMAN 355  // yaman
#define STR_RES_KAFI 356  // kafi
#define STR_RES_BHIMPALASREE 357  // bhimpalasree
#define STR_RES_DARBARI 358  // darbari
#define STR_RES_BAGESHREE 359  // bageshree
#define STR_RES_RAGESHREE 360  // rageshree
#define STR_RES_KHAMAJ 361  // khamaj
#define STR_RES_MIMAL 362  // mi'mal
#define STR_RES_PARAMESHWARI 363  // parameshwari
#define STR_RES_RANGESHWARI 364  // rangeshwari
#define STR_RES_GANGESHWARI 365  // gangeshwari
#define STR_RES_KAMESHWARI 366  // kameshwari
#define STR_RES_PA__KAFI 367  // pa. kafi
#define STR_RES_NATBHAIRAV 368  // natbhairav
#define STR_RES_M_KAUNS 369  // m.kauns
#define STR_RES_BAIRAGI 368  // bairagi
#define STR_RES_B_TODI 371  // b.todi
#define STR_RES_CHANDRADEEP 372  // chandradeep
#define STR_RES_KAUSHIK_TODI 373  // kaushik todi
#define STR_RES_JOGESHWARI 374  // jogeshwari
#define STR_RES_RASIA 375  // rasia
#define LUT_RES_LFO_INCREMENTS 0
#define LUT_RES_LFO_INCREMENTS_SIZE 128
#define LUT_RES_SCALE_JUST 1
#define LUT_RES_SCALE_JUST_SIZE 12
#define LUT_RES_SCALE_PYTHAGOREAN 2
#define LUT_RES_SCALE_PYTHAGOREAN_SIZE 12
#define LUT_RES_SCALE_1_4_EB 3
#define LUT_RES_SCALE_1_4_EB_SIZE 12
#define LUT_RES_SCALE_1_4_E 4
#define LUT_RES_SCALE_1_4_E_SIZE 12
#define LUT_RES_SCALE_1_4_EA 5
#define LUT_RES_SCALE_1_4_EA_SIZE 12
#define LUT_RES_SCALE_BHAIRAV 6
#define LUT_RES_SCALE_BHAIRAV_SIZE 12
#define LUT_RES_SCALE_GUNAKRI 7
#define LUT_RES_SCALE_GUNAKRI_SIZE 12
#define LUT_RES_SCALE_MARWA 8
#define LUT_RES_SCALE_MARWA_SIZE 12
#define LUT_RES_SCALE_SHREE 9
#define LUT_RES_SCALE_SHREE_SIZE 12
#define LUT_RES_SCALE_PURVI 10
#define LUT_RES_SCALE_PURVI_SIZE 12
#define LUT_RES_SCALE_BILAWAL 11
#define LUT_RES_SCALE_BILAWAL_SIZE 12
#define LUT_RES_SCALE_YAMAN 12
#define LUT_RES_SCALE_YAMAN_SIZE 12
#define LUT_RES_SCALE_KAFI 13
#define LUT_RES_SCALE_KAFI_SIZE 12
#define LUT_RES_SCALE_BHIMPALASREE 14
#define LUT_RES_SCALE_BHIMPALASREE_SIZE 12
#define LUT_RES_SCALE_DARBARI 15
#define LUT_RES_SCALE_DARBARI_SIZE 12
#define LUT_RES_SCALE_BAGESHREE 16
#define LUT_RES_SCALE_BAGESHREE_SIZE 12
#define LUT_RES_SCALE_RAGESHREE 17
#define LUT_RES_SCALE_RAGESHREE_SIZE 12
#define LUT_RES_SCALE_KHAMAJ 18
#define LUT_RES_SCALE_KHAMAJ_SIZE 12
#define LUT_RES_SCALE_MIMAL 19
#define LUT_RES_SCALE_MIMAL_SIZE 12
#define LUT_RES_SCALE_PARAMESHWARI 20
#define LUT_RES_SCALE_PARAMESHWARI_SIZE 12
#define LUT_RES_SCALE_RANGESHWARI 21
#define LUT_RES_SCALE_RANGESHWARI_SIZE 12
#define LUT_RES_SCALE_GANGESHWARI 22
#define LUT_RES_SCALE_GANGESHWARI_SIZE 12
#define LUT_RES_SCALE_KAMESHWARI 23
#define LUT_RES_SCALE_KAMESHWARI_SIZE 12
#define LUT_RES_SCALE_PA__KAFI 24
#define LUT_RES_SCALE_PA__KAFI_SIZE 12
#define LUT_RES_SCALE_NATBHAIRAV 25
#define LUT_RES_SCALE_NATBHAIRAV_SIZE 12
#define LUT_RES_SCALE_M_KAUNS 26
#define LUT_RES_SCALE_M_KAUNS_SIZE 12
#define LUT_RES_SCALE_BAIRAGI 27
#define LUT_RES_SCALE_BAIRAGI_SIZE 12
#define LUT_RES_SCALE_B_TODI 28
#define LUT_RES_SCALE_B_TODI_SIZE 12
#define LUT_RES_SCALE_CHANDRADEEP 29
#define LUT_RES_SCALE_CHANDRADEEP_SIZE 12
#define LUT_RES_SCALE_KAUSHIK_TODI 30
#define LUT_RES_SCALE_KAUSHIK_TODI_SIZE 12
#define LUT_RES_SCALE_JOGESHWARI 31
#define LUT_RES_SCALE_JOGESHWARI_SIZE 12
#define LUT_RES_SCALE_RASIA 32
#define LUT_RES_SCALE_RASIA_SIZE 12
#define LUT_RES_ARPEGGIATOR_PATTERNS 33
#define LUT_RES_ARPEGGIATOR_PATTERNS_SIZE 22
#define LUT_RES_GROOVE_SWING 34
#define LUT_RES_GROOVE_SWING_SIZE 16
#define LUT_RES_GROOVE_SHUFFLE 35
#define LUT_RES_GROOVE_SHUFFLE_SIZE 16
#define LUT_RES_GROOVE_PUSH 36
#define LUT_RES_GROOVE_PUSH_SIZE 16
#define LUT_RES_GROOVE_LAG 37
#define LUT_RES_GROOVE_LAG_SIZE 16
#define LUT_RES_GROOVE_HUMAN 38
#define LUT_RES_GROOVE_HUMAN_SIZE 16
#define LUT_RES_GROOVE_MONKEY 39
#define LUT_RES_GROOVE_MONKEY_SIZE 16
#define CHR_RES_SPECIAL_CHARACTERS 0
#define CHR_RES_SPECIAL_CHARACTERS_SIZE 56
#define WAV_RES_LFO_WAVEFORMS 0
#define WAV_RES_LFO_WAVEFORMS_SIZE 4112

using ResourcesManager = avrlib::ResourcesManager<ResourceId,
    avrlib::ResourcesTables<string_table, lookup_table_table>>;

}  // namespace ambika

#endif  // CONTROLLER_RESOURCES_H_
