MachFour/ambika/controller/part.h

// Copyright 2011 Emilie Gillet.
//
// Author: Emilie Gillet (emilie.o.gillet@gmail.com)
//
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
// -----------------------------------------------------------------------------
//
// "Part" is the dumb data structure storing the part settings.
// "PartManager" is responsible for handling a bunch of voicecards assigned
// to the same logical part.

#ifndef CONTROLLER_PART_H_
#define CONTROLLER_PART_H_

#include "avrlib/base.h"

#include "common/lfo.h"
#include "common/patch.h"

#include "controller/controller.h"
#include "controller/note_stack.h"
#include "controller/voice_allocator.h"

namespace ambika {
  
enum InitializationMode : uint8_t {
  INITIALIZATION_DEFAULT,
  INITIALIZATION_RANDOM
};

enum ArpeggiatorDirection : uint8_t {
  ARPEGGIO_DIRECTION_UP = 0,
  ARPEGGIO_DIRECTION_DOWN,
  ARPEGGIO_DIRECTION_UP_DOWN,
  ARPEGGIO_DIRECTION_AS_PLAYED,
  ARPEGGIO_DIRECTION_RANDOM,
  ARPEGGIO_DIRECTION_CHORD,
  ARPEGGIO_DIRECTION_LAST
};

enum ArpSequencerMode : uint8_t {
  ARP_SEQUENCER_MODE_STEP,
  ARP_SEQUENCER_MODE_ARPEGGIATOR,
  ARP_SEQUENCER_MODE_NOTE,
  ARP_SEQUENCER_MODE_LAST
};

enum PolyphonyMode : uint8_t {
  MONO,
  POLY,
  UNISON_2X,
  CYCLIC,
  CHAIN,
  POLYPHONY_MODE_LAST
};

enum PartFlags : uint8_t {
  FLAG_HAS_CHANGE = 1,
  FLAG_HAS_USER_CHANGE = 2,
};

static const uint8_t kNumSequences = 3;

struct NoteStep {
  uint8_t note;
  uint8_t velocity;
  uint8_t legato;
  uint8_t gate;
};

struct PartData {
  struct Parameters {
    // Offset: 0
    uint8_t volume;

    // Offset: 1-5
    int8_t octave;
    int8_t tuning;
    uint8_t spread;
    uint8_t raga;

    // Offset: 5-8
    uint8_t legato;
    uint8_t portamento_time;
    ArpSequencerMode arp_sequencer_mode;

    // Offset: 8-12
    ArpeggiatorDirection arp_direction;
    uint8_t arp_octave;
    uint8_t arp_pattern;
    uint8_t arp_divider;

    // Offset: 12..16
    uint8_t sequence_length[kNumSequences];
    PolyphonyMode polyphony_mode;

    // Offset: 16-80
    //  0..15: step sequence 1
    // 16..31: step sequence 2
    // 32..63: (note value | 0x80 if gate), (note velocity | 0x80 if legato)
    uint8_t sequence_data[64];

    // Offset: 80-84
    uint8_t padding[4];
  };

  // also refers to metadata before it
  static constexpr uint8_t sequence_data_size =
        sizeof(Parameters::arp_direction)   //    1
      + sizeof(Parameters::arp_octave)      // +  1
      + sizeof(Parameters::arp_pattern)     // +  1
      + sizeof(Parameters::arp_divider)     // +  1
      + sizeof(Parameters::sequence_length) // +  3
      + sizeof(Parameters::polyphony_mode)  // +  1
      + sizeof(Parameters::sequence_data);  // + 64
  // = 72 (like in original code)


private:
  union Data {
    Parameters params;
    uint8_t bytes[sizeof(Parameters)];

    explicit Data(Parameters p) : params(p) {};
    explicit Data() : params() {};
  };

  Data data;

public:

  constexpr static inline size_t sizeBytes() {
    return sizeof(Parameters);
  }

  inline void setData(uint8_t address, uint8_t value) {
    data.bytes[address] = value;
  }
  inline uint8_t getData(uint8_t address) const {
    return data.bytes[address];
  }

  inline Parameters* params_addr() {
    return &data.params;
  }

  // raw access to underlying bytes
  inline uint8_t* bytes() {
    return data.bytes;
  }
  inline const uint8_t* bytes_readonly() const {
    return data.bytes;
  }

  // accessor/mutator functions for the parameters
  inline uint8_t* pure_sequence_data() {
    return data.params.sequence_data;
  }

  // actually contains sequence data and metadata,
  // corresponds to raw_sequence_data in past code
  // contains 72 bytes
  inline uint8_t* sequence_data() {
    // start at arp_direction
    //return &data.params.arp_direction;
    return data.bytes + 8;
  }
  inline const uint8_t* sequence_data_readonly() const {
    // start at arp_direction
    //return &data.params.arp_direction;
    return data.bytes + 8;
  }

  inline uint8_t& volume() {
    return data.params.volume;
  }
  inline int8_t& octave() {
    return data.params.octave;
  }
  inline int8_t& tuning() {
    return data.params.tuning;
  }
  inline uint8_t& spread() {
    return data.params.spread;
  }
  inline uint8_t& raga() {
    return data.params.raga;
  }
  inline uint8_t& legato() {
    return data.params.legato;
  }
  inline uint8_t& portamento_time() {
    return data.params.portamento_time;
  }
  inline ArpSequencerMode & arp_sequencer_mode() {
    return data.params.arp_sequencer_mode;
  }
  inline ArpeggiatorDirection& arp_direction() {
    return data.params.arp_direction;
  }
  inline uint8_t& arp_octave() {
    return data.params.arp_octave;
  }
  inline uint8_t& arp_pattern() {
    return data.params.arp_pattern;
  }
  inline uint8_t& arp_divider() {
    return data.params.arp_divider;
  }
  inline uint8_t& sequence_length(uint8_t index) {
    return data.params.sequence_length[index];
  }
  inline PolyphonyMode& polyphony_mode() {
    return data.params.polyphony_mode;
  }

  // more functions

  uint8_t step_value(uint8_t sequence, uint8_t step) const {
    const auto index = byteAnd(step + (sequence << 4u), 0x1f);
    return data.params.sequence_data[index];
  }
  
  void set_step_value(uint8_t sequence, uint8_t step, uint8_t value) {
    const auto index = byteAnd(step + (sequence << 4u), 0x1f);
    data.params.sequence_data[index] = value;
  }

private:
  // used in (set_){note,ordered_gate_velocity,note_step} functions
  inline uint8_t get_note_offset(uint8_t step) const {
    return byteAnd(32 + (step << 1u), 0x3f);
  }

public:
  uint8_t note(uint8_t step) const {
    auto offset = get_note_offset(step);
    return U7(data.params.sequence_data[offset]);
  }
  
  void set_note(uint8_t step, uint8_t note) {
    auto offset = get_note_offset(step);
    data.params.sequence_data[offset] &= 0x80u;
    data.params.sequence_data[offset] |= note;
  }
  
  uint16_t ordered_gate_velocity(uint8_t step) const {
    auto offset = get_note_offset(step);
    if (!byteAnd(data.params.sequence_data[offset], 0x80)) {
      return 0;
    } else {
      uint8_t o = data.params.sequence_data[offset + 1] + 128;
      return U16(o) + 1;
    }
  }
  
  void set_ordered_gate_velocity(uint8_t step, uint16_t value) {
    auto offset = get_note_offset(step);
    if (!value) {
      data.params.sequence_data[offset] &= 0x7f;
      data.params.sequence_data[offset + 1] = 0;
    } else {
      data.params.sequence_data[offset] |= 0x80;
      data.params.sequence_data[offset + 1] = (value - 1) + 128;
    }
  }
  
  void set_velocity(uint8_t step, uint8_t velocity) {
    auto offset = get_note_offset(step);
    data.params.sequence_data[offset + 1] &= 0x80;
    data.params.sequence_data[offset + 1] |= velocity;
  }
  
  NoteStep note_step(uint8_t step) const {
    NoteStep n;
    auto offset = get_note_offset(step);
    n.note = data.params.sequence_data[offset];
    n.velocity = data.params.sequence_data[offset + 1];
    n.gate = byteAnd(n.note, 0x80);
    n.legato = byteAnd(n.velocity, 0x80);
    n.note = U7(n.note);
    n.velocity = U7(n.velocity);
    return n;
  }
};

enum PartParameter : uint8_t {
  PRM_PATCH = 0,
  // These enums have to match the order of members in PartData::Parameters
  PRM_PART_VOLUME = Patch::sizeBytes(), // TODO move these into the actual classes
  PRM_PART_OCTAVE,
  PRM_PART_TUNING,
  PRM_PART_TUNING_SPREAD,
  PRM_PART_RAGA,
  PRM_PART_LEGATO,
  PRM_PART_PORTAMENTO_TIME,
  PRM_PART_ARP_MODE,
  PRM_PART_ARP_DIRECTION,
  PRM_PART_ARP_OCTAVE,
  PRM_PART_ARP_PATTERN,
  PRM_PART_ARP_RESOLUTION,
  PRM_PART_SEQUENCE_LENGTH_1,
  PRM_PART_SEQUENCE_LENGTH_2,
  PRM_PART_SEQUENCE_LENGTH_3,
  PRM_PART_POLYPHONY_MODE
};

class Part {
 public:
  Part() = default;
  void Init();

  void InitPatch(InitializationMode mode);
  void InitSettings(InitializationMode mode);
  void InitSequence(InitializationMode mode);
  
  void NoteOn(uint8_t note, uint8_t velocity);
  void NoteOff(uint8_t note);
  void ControlChange(uint8_t controller, uint8_t value);
  void PitchBend(uint16_t pitch_bend);
  void Aftertouch(uint8_t note, uint8_t velocity);
  void Aftertouch(uint8_t velocity);
  void AllSoundOff();
  void ResetAllControllers();
  void AllNotesOff();
  void MonoModeOn(uint8_t num_channels);
  void PolyModeOn();
  void Reset();
  void Clock();
  void Start();
  void Stop();

  constexpr static inline size_t sizeBytes() {
    return Patch::sizeBytes() + PartData::sizeBytes();
  }
  
  uint8_t num_pressed_keys() const { return pressed_keys_.size(); }
  
  void SetValue(uint8_t address, uint8_t value, uint8_t user_initiated);
  
  inline uint8_t GetValue(uint8_t address) const {
    return patch_.getData(address);
  }

  inline PartData& data() {
    return data_;
  }

  inline const PartData& data_readonly() const {
    return data_;
  }

  inline uint8_t* raw_sequence_data() {
    return data_.sequence_data();
  }
  inline const uint8_t* raw_sequence_data_readonly() const {
    return data_.sequence_data_readonly();
  }

  inline uint8_t* raw_data() {
    return data_.bytes();
  }

  inline const uint8_t* raw_data_readonly() const {
    return data_.bytes_readonly();
  }

  inline uint8_t* raw_patch_data() {
    return patch_.bytes();
  }

  inline const uint8_t* raw_patch_data_readonly() const {
    return patch_.bytes_readonly();
  }

  uint8_t lfo_value(uint8_t index) const { return lfo_previous_values_[index]; }
  uint8_t step(uint8_t index) const { return sequencer_step_[index]; }

  void Touch();
  void TouchPatch();
  void UpdateLfos(uint8_t refresh_cycle);
  
  void AssignVoices(uint8_t allocation);
  inline uint8_t flags() const {
    return flags_;
  }
  inline void ClearFlag(uint8_t flag) { flags_ &= byteInverse(flag); }
  

 private:
  void RandomizeRange(uint8_t start, uint8_t size);
  void InitializeAllocators();
  //void TouchVoiceAllocation();
  void TouchClock();
  void TouchLfos();
  
  void RetriggerLfos();
  
  // Called on each "tick" of the arpeggiator and sequencer clock.
  void ClockSequencer();
  void ClockArpeggiator();
  
  // Called whenever a new arpeggiator note has to be triggered.
  void StartArpeggio();
  void StepArpeggio();
  
  void WriteToAllVoices(uint8_t data_type, uint8_t address, uint8_t value);
   
  // Check whether a note should be played by this part. A note can be rejected
  // if it is outside of the split region, or if it is outside of the selected
  // scale/raga.
  uint8_t AcceptNote(uint8_t note); // const
  uint16_t TuneNote(uint8_t midi_note); // const

  void InternalNoteOn(uint8_t note, uint8_t velocity);
  void InternalNoteOff(uint8_t note);
  
  uint8_t GetNextVoice(uint8_t voice_index) const;

  Patch patch_;
  PartData data_;
  
  uint8_t allocated_voices_[kNumVoices];
  uint8_t num_allocated_voices_;
  
  Lfo lfo_[kNumLfos];
  uint8_t lfo_step_[kNumLfos];
  uint8_t lfo_cycle_length_[kNumLfos];
  uint8_t lfo_previous_values_[kNumLfos];
  uint8_t lfo_refresh_cycle_;
  // This variable is used to get an estimate of the MIDI clock tick duration
  // expressed in 1/976 seconds (LFO refresh rate).
  uint16_t midi_clock_tick_duration_;
  
  uint8_t midi_clock_prescaler_;
  uint8_t midi_clock_counter_;

  // A part will ignore all incoming note off messages if the sustain pedal
  // is held.
  uint8_t ignore_note_off_messages_;
  NoteStack<12> pressed_keys_;
  NoteStack<7> mono_allocator_;
  VoiceAllocator poly_allocator_;
  
  uint8_t data_entry_msb_;
  uint8_t nrpn_msb_;
  uint8_t nrpn_;
  
  // Sequencer state.
  uint8_t sequencer_step_[kNumSequences];
  
  // Arpeggiator state.
  uint8_t previous_generated_note_;
  uint16_t arp_pattern_mask_;
  int8_t arp_direction_;
  int8_t arp_step_;
  int8_t arp_octave_;
  
  // Whether some settings have been changed by code.
  uint8_t flags_;
  
  // Backup copy of the "polyphony mode" parameter to reinitialize if necessary
  // all allocators when a new program is loaded.
  uint8_t polyphony_mode_;
  
  DISALLOW_COPY_AND_ASSIGN(Part);
};

}  // namespace ambika

#endif  // CONTROLLER_PART_H_
