MachFour/ambika/voicecard/oscillator.h

// Copyright 2011 Emilie Gillet.
//
// Author: Emilie Gillet (emilie.o.gillet@gmail.com)
//
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
// -----------------------------------------------------------------------------
//
// Oscillators. Note that the code of each oscillator is duplicated/specialized,
// for a noticeable performance boost.

#ifndef VOICECARD_OSCILLATOR_H_
#define VOICECARD_OSCILLATOR_H_

#include "avrlib/op.h"
#include "avrlib/random.h"

#include "common/patch.h"

#include "voicecard/resources.h"

using namespace avrlib;

namespace ambika {

//__attribute__((always_inline))
static inline uint8_t ReadSample(const uint8_t* table, uint16_t phase) {
  return ResourcesManager::Lookup<uint8_t, uint8_t>(table, highByte(phase));
}

static inline uint8_t InterpolateTwoTables(const uint8_t* table_a, const uint8_t* table_b,
      uint16_t phase, uint8_t gain_a, uint8_t gain_b) {
  auto a = InterpolateSample(table_a, phase);
  auto b = InterpolateSample(table_b, phase);
  return U8Mix(a, b, gain_a, gain_b);
}

static const uint8_t kNumZonesFullSampleRate = 6;
static const uint8_t kNumZonesHalfSampleRate = 5;

struct VowelSynthesizerState {
  uint16_t formant_increment[3];
  uint16_t formant_phase[3];
  uint8_t formant_amplitude[4]; // last entry represents noise_modulation
  //uint8_t noise_modulation;
  uint8_t update;  // Update only every kVowelControlRateDecimation-th call.
};

struct FilteredNoiseState {
  uint8_t lp_noise_sample;
  uint16_t rng_state;
  uint16_t rng_reset_value;
};

struct QuadSawPadState {
  uint16_t phase[3];
};

union OscillatorState {
  VowelSynthesizerState vw;
  FilteredNoiseState no;
  QuadSawPadState qs;
  // for FM synthesis
  uint24_t secondary_phase;
  // used in polyblep algorithms
  uint8_t output_sample;
};

class Oscillator {
 public:
  using RenderFn = void (Oscillator::*)(uint8_t*);
   
  Oscillator() = default;

  inline void Reset() {
    data.no.rng_reset_value = Random::GetByte() + 1;
  }

  inline void Render(OscillatorAlgorithm new_shape, uint8_t new_note, uint24_t new_phase_increment,
                     bool* new_sync_input, bool* new_sync_output, uint8_t* buffer) {
    shape = new_shape;
    note = new_note;
    phase_increment = new_phase_increment;
    sync_input = new_sync_input;
    sync_output = new_sync_output;
    // A hack: when pulse width is set to 0, use a simple wavetable.
    if (new_shape == WAVEFORM_SQUARE) {
      if (parameter == 0) {
        RenderSimpleWavetable(buffer);
      } else {
        RenderBandlimitedPwm(buffer);
      }
    } else {
      uint8_t index = new_shape >= WAVEFORM_WAVETABLE_1 ? WAVEFORM_WAVETABLE_1 : new_shape;
      RenderFn fn;
      ResourcesManager::Load(fn_table, index, &fn);
      if (new_shape == WAVEFORM_WAVEQUENCE) {
        fn = &Oscillator::RenderWavequence;
      }
      (this->*fn)(buffer);
    }
  }
  
  inline void set_parameter(uint8_t new_parameter) {
    parameter = new_parameter;
  }
  
  inline void set_fm_parameter(uint8_t new_fm_parameter) {
    fm_parameter = new_fm_parameter;
  }
  
 private:
  // Current phase of the oscillator.
  uint24_t phase;

  // Phase increment (and phase increment x 2, for low-sr oscillators).
  uint24_t phase_increment;

  // Copy of the shape used by this oscillator. When changing this, you
  // should also update the Update/Render pointers.
  OscillatorAlgorithm shape;

  // Current value of the oscillator parameter.
  uint8_t parameter;
  uint8_t fm_parameter;
  uint8_t note;

  // Union of state data used by each algorithm.
  OscillatorState data;
  // A flag set to true when sync is enabled ; and a table to record the
  // position of phrase wraps
  bool* sync_input;
  bool* sync_output;

  inline static bool update_phase_and_sync(uint24_t& phase, const uint24_t& phase_increment, bool*& sync_in, bool*& sync_out);

  void RenderSilence(uint8_t* buffer);
  void RenderBandlimitedPwm(uint8_t* buffer);
  void RenderSimpleWavetable(uint8_t* buffer);
  void RenderCzSaw(uint8_t* buffer);
  //void RenderCzResoSaw(uint8_t* buffer);
  //void RenderCzResoPulse(uint8_t* buffer);
  //void RenderCzResoTri(uint8_t* buffer);
  void RenderCzResoWave(uint8_t* buffer);
  void RenderFm(uint8_t* buffer);
  void Render8BitLand(uint8_t* buffer);
  void RenderVowel(uint8_t* buffer);
  void RenderDirtyPwm(uint8_t* buffer);
  void RenderQuadSawPad(uint8_t* buffer);
  void RenderFilteredNoise(uint8_t* buffer);
  void RenderInterpolatedWavetable(uint8_t* buffer);
  void RenderWavequence(uint8_t* buffer);
  // polyblep synthesis methods by Bjarne (bjoeri on github)
  //void RenderPolyBlepSaw(uint8_t* buffer);
  //void RenderPolyBlepPwm(uint8_t* buffer);
  //void RenderPolyBlepCSaw(uint8_t* buffer);
  // combines previous three functions
  void RenderPolyBlepWave(uint8_t* buffer);

    // Pointer to the render function.
  static constexpr RenderFn fn_table[] PROGMEM {
      &Oscillator::RenderSilence,

      &Oscillator::RenderSimpleWavetable,
      &Oscillator::RenderBandlimitedPwm,
      &Oscillator::RenderSimpleWavetable,
      &Oscillator::RenderSimpleWavetable,

      &Oscillator::RenderCzSaw,
      &Oscillator::RenderCzResoWave, // saw (LP)
      &Oscillator::RenderCzResoWave, // saw (BP)
      &Oscillator::RenderCzResoWave, // saw (HP)
      &Oscillator::RenderCzResoWave, // saw (PK)
      &Oscillator::RenderCzResoWave, // pulse (LP)
      &Oscillator::RenderCzResoWave, // pulse (BP)
      &Oscillator::RenderCzResoWave, // pulse (HP)
      &Oscillator::RenderCzResoWave, // pulse (PK)
      &Oscillator::RenderCzResoWave, // tri (LP)

      &Oscillator::RenderQuadSawPad,

      &Oscillator::RenderFm,

      &Oscillator::Render8BitLand,
      &Oscillator::RenderDirtyPwm,
      &Oscillator::RenderFilteredNoise,
      &Oscillator::RenderVowel,

      &Oscillator::RenderPolyBlepWave, // saw
      &Oscillator::RenderPolyBlepWave, //pwm
      &Oscillator::RenderPolyBlepWave, // csaw

      &Oscillator::RenderInterpolatedWavetable,
  };


  DISALLOW_COPY_AND_ASSIGN(Oscillator);
};

}  // namespace ambika

#endif  // VOICECARD_OSCILLATOR_H_
