MachFour/ambika/common/lfo.h

// Copyright 2009 Emilie Gillet.
//
// Author: Emilie Gillet (emilie.o.gillet@gmail.com)
//
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
// -----------------------------------------------------------------------------
//
// LFO (cheap oscillator).
//
// Contrary to oscillators which are templatized "static singletons", to
// generate the fastest, most specialized code, LFOs are less
// performance-sensitive and are thus implemented as a traditional class.

#ifndef COMMON_LFO_H_
#define COMMON_LFO_H_

#include "avrlib/base.h"
#include "avrlib/op.h"
#include "avrlib/random.h"
#include "common/patch.h"

using avrlib::InterpolateSample;
using avrlib::Random;

namespace ambika {

extern const uint8_t wav_res_lfo_waveforms[] PROGMEM;

class Lfo {
 public:
  Lfo() = default;

  uint8_t Render(LfoWave shape) {
    phase += phase_increment;
    phase_reset = phase < phase_increment;

    const uint8_t phase_byte = highByte(phase);
    // Compute the LFO value.
    uint8_t value;
    switch (shape) {
      case LFO_WAVEFORM_RAMP:
        value = phase_byte;
        break;
      case LFO_WAVEFORM_S_H:
        if (phase_reset) {
          s_h_value = Random::GetByte();
        }
        value = s_h_value;
        break;
      case LFO_WAVEFORM_TRIANGLE:
        value = byteAnd(phase_byte, 0x80) ? phase >> 7u : byteInverse(phase >> 7u);
        break;
      case LFO_WAVEFORM_SQUARE:
        value = byteAnd(phase_byte, 0x80) ? 255 : 0;
        break;
      default:
        {
#ifndef DISABLE_WAVETABLE_LFOS
          uint8_t shape_offset = shape - LFO_WAVEFORM_WAVE_1;
          uint16_t offset = word(shape_offset, shape_offset); // == (shape_offset << 8) + shape_offset == shape_offset * 257
          value = InterpolateSample(wav_res_lfo_waveforms + offset, phase);
#else
        new_value = 0;
#endif  // DISABLE_WAVETABLE_LFOS
        }
        break;
    }
    return value;
  }

  void set_phase(uint16_t new_phase) {
    phase_reset = (new_phase <= phase);
    phase = new_phase;
  }
  

  void set_phase_increment(uint16_t new_phase_increment) {
    phase_increment = new_phase_increment;
  }
  
  inline uint8_t looped() const {
    return phase_reset;
  }

 private:
  // Phase increment.
  uint16_t phase_increment;

  // Current phase of the lfo.
  uint16_t phase;
  bool phase_reset;

  // Current value of S&H.
  uint8_t s_h_value;

  DISALLOW_COPY_AND_ASSIGN(Lfo);
};

}  // namespace ambika

#endif  // COMMON_LFO_H_
