MachFour/ambika/(commit log)

2020-03-22 fixed for compilation with GCC 8+, refactoring, voicecards not fully working yet
    [Mobo-v09.brd, Mobo-v09.sch]
2020-03-23 reworking of major data structures to use safer pointer code, reduce clang-tidy warnings
    [envelope.h, multi.h, note_stack.h, oscillator.cc, oscillator.h, parameter.cc, part.cc, part.h]
2020-03-29 fix stupid bugs, improved variable naming
    [oscillator.cc, oscillator.h, voice.cc, voice.h]
2020-03-29 refactoring of variable names and computations, still can't find the final bug...
    [Mobo-v09.brd, Mobo-v09.sch]
2020-04-16 fixed bug in triangle reso, commented some stuff
    [oscillator.cc, oscillator.h, patch.h]
2020-04-18 fixed a bug in library.cc, more refactoring
    [bootloader.cc, midi_dispatcher.h, storage.cc, storage.h]
2020-04-18 fixed LFO bugs, enum refactoring
    [lfo.h, part.cc, part.h, patch.h, voice.cc, voicecard_rx.h, voicecard_tx.cc]
2020-08-29 fixed bug in performance page caused by incomplete refactoring
    [multi.h]
