MachFour/ambika/(notices)

Notices in the files:
controller/controller.cc:
This program is free software: you can redistribute it and/or modify
it under the terms of the GNU General Public License as published by
the Free Software Foundation, either version 3 of the License, or
(at your option) any later version.
controller/hardware_design/pcb/max/Mobo-v09.brd:
cc-by-sa, Emilie Gillet. v0.9
